BJCaasenbrood/ICORR2022/stl/interface_V5.2_offset.STL

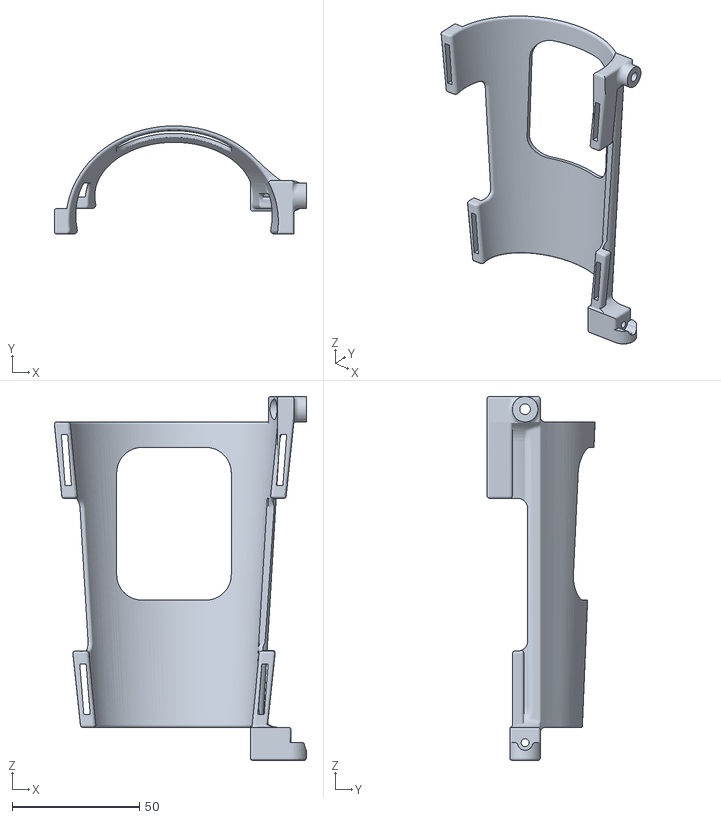
[picture p8: CAD file, 2022-07-22]
stl/interface_V5.2_offset.STL
99.1 x 42.5 x 143.0
